Alifizz01/BridgeSense/docs/calibration_table.csv

i_v | j_t | coef_pa
0 | 0 | -974.613537
0 | 1 | -324.63861
0 | 2 | -166.660407
1 | 0 | 9716.27727
1 | 1 | 958.183345
1 | 2 | 13.2528959
2 | 0 | 232.049728
2 | 1 | 29.1941115
2 | 2 | -49.1930878
3 | 0 | 2.9542962
3 | 1 | 12.4113069
3 | 2 | 33.9777578
